gustavwrisberg/room-panel/hardware/kicad/production/bom.csv

Designator | Footprint | Quantity | Value | LCSC Part #
C10, C11, C12, C13, C14, C9 | 0402 | 6 | 100 nF | C1525
C15, C16 | 0402 | 2 | 10 nF | C15195
C7 | 0805 | 1 | 10 µF | C15850
J1 | C4002 | 1 | Conn_01x05
J2 | PinSocket_2x05_P2.54mm_Vertical | 1 | Conn_02x05_Odd_Even
J3 | JST_PH_B8B-PH-K_1x08_P2.00mm_Vertical | 1 | Conn_01x08
J4 | PinSocket_1x04_P2.54mm_Vertical | 1 | Conn_01x04
R10, R8, R9 | 0402 | 3 | 4k7 | C25900
R11, R12 | 0402 | 2 | 10k | C25744
SW1 | SW-SMD_BMQ22-N1A1-2012-A | 1 | BMQ22-N1A1-2012-A | C52740763
SW2, SW3, SW4, SW5 | SW-SMD_4P-L5.1-W5.1-P3.70-LS6.5-TL_H1.5 | 4 | TS-1187A-S16 | C318884
U1 | DFN-4_L1.5-W1.5-P0.80-TL-EP | 1 | SHT40-N-NF | C54946589
U2 | XIAO-ESP32-C6-SMD | 1 | XIAO-ESP32-C6-SMD | C27675191
U4 | WSOF-6_L2.6-W1.6-P0.50-TL-EP | 1 | BH1750FVI-TR | C78960
U5 | TSSOP-16_L5.0-W4.4-P0.65-LS6.4-BL | 1 | PCA9554PW,118 | C17230
