gustavwrisberg/room-panel/hardware/case/out/assembly.step

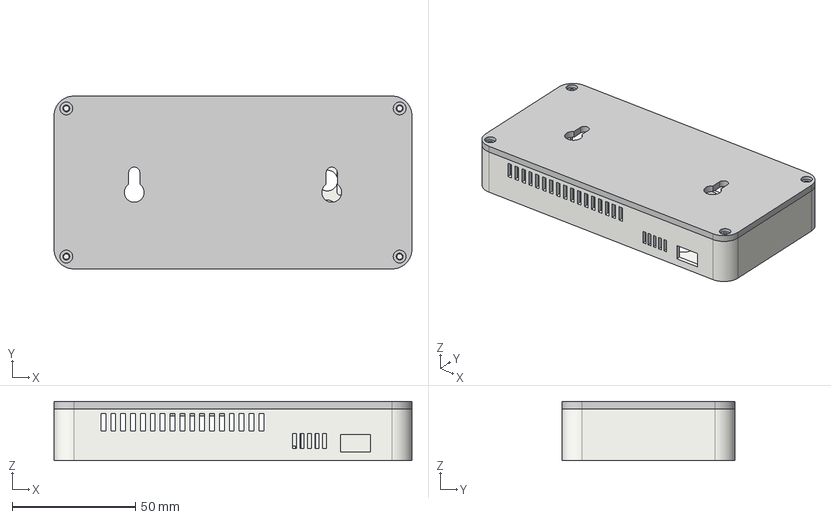
[picture p4: CAD file, 2026-11-03]
hardware/case/out/assembly.step
145.0 x 70.0 x 24.0 mm
front_shell
back_plate
