gustavwrisberg/room-panel/hardware/case/out/button_cap.step

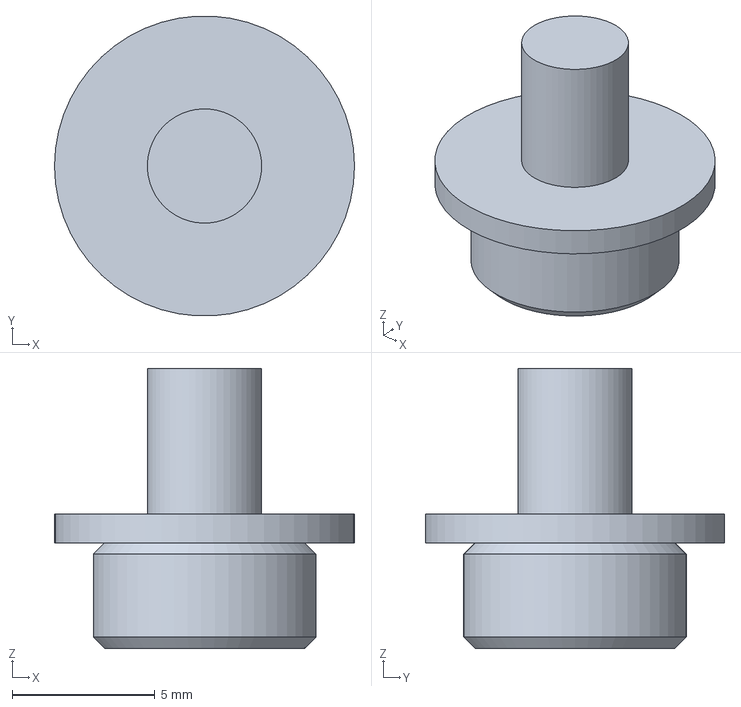
[picture p5: CAD file, 2026-11-03]
hardware/case/out/button_cap.step
10.5 x 10.5 x 9.80 mm
