gustavwrisberg/room-panel/hardware/case/out/back_plate.step

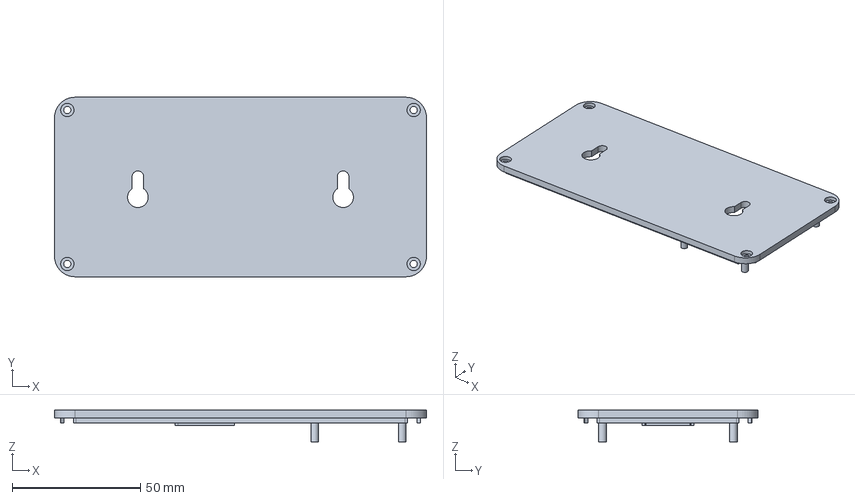
[picture p6: CAD file, 2026-11-03]
hardware/case/out/back_plate.step
145.0 x 70.0 x 12.4 mm
