gustavwrisberg/room-panel/hardware/case/out/knob.step

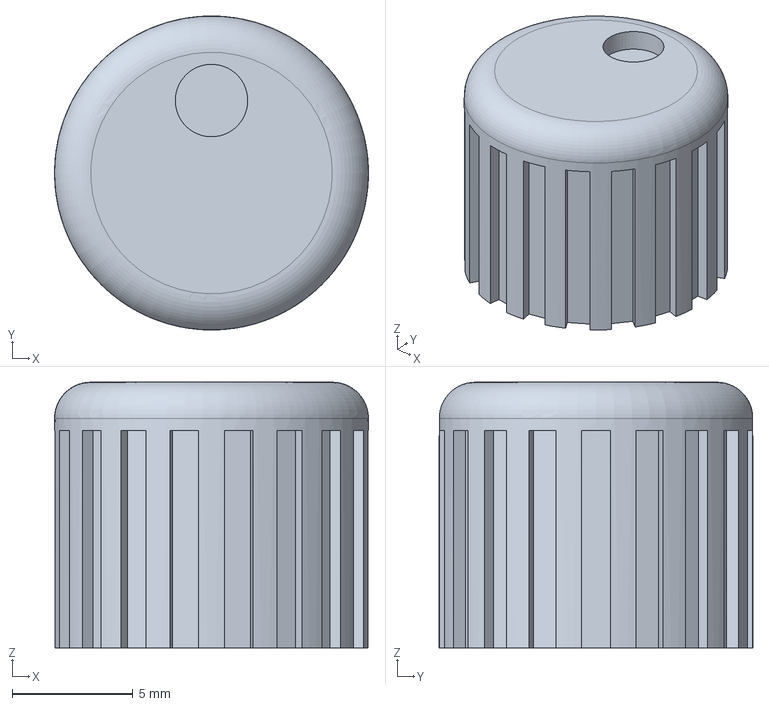
[picture p7: CAD file, 2026-11-03]
hardware/case/out/knob.step
13.0 x 13.0 x 11.0 mm
