gustavwrisberg/room-panel/hardware/case/out/front_shell.step

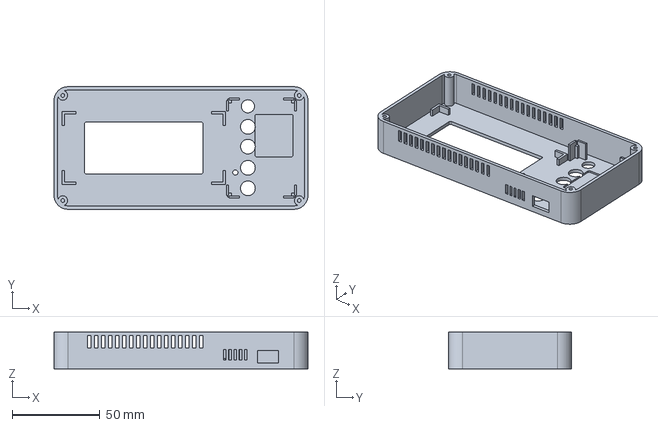
[picture p8: CAD file, 2026-11-03]
hardware/case/out/front_shell.step
145.0 x 70.0 x 21.0 mm
