gustavwrisberg/room-panel/(list of files, cad)

Other CAD files:
hardware/case/out/back_plate.stl
hardware/case/out/button_cap.stl
hardware/case/out/front_shell.stl
hardware/case/out/knob.stl
