gustavwrisberg/room-panel/hardware/kicad/Smart_home_universal_board.kicad_pcb

## KiCad design hardware/kicad/Smart_home_universal_board.kicad_pcb (2026-11-03)

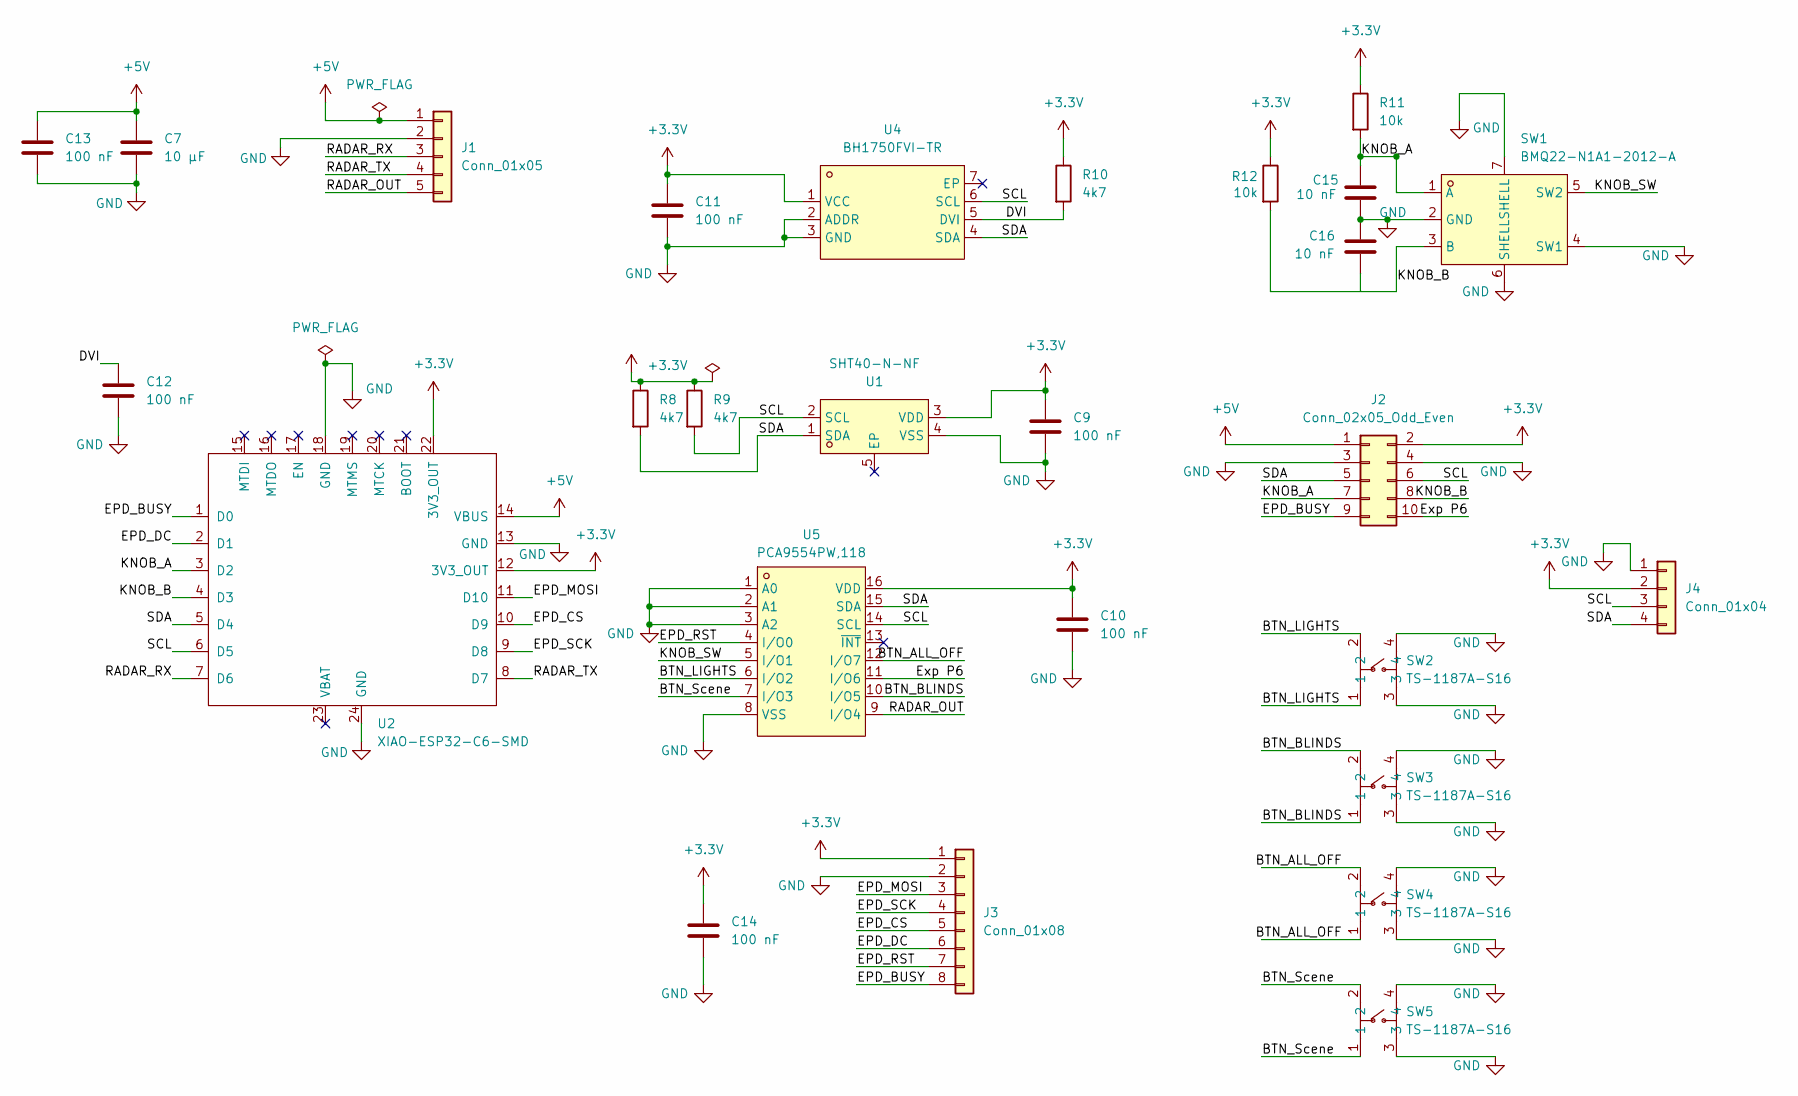
[picture p9: schematic Smart_home_universal_board.kicad_sch]

Parts:
C7: 10 µF; C_0805_2012Metric; LCSC Part C15850
C9, C10, C11, C12, C13, C14: 100 nF; C_0402_1005Metric; LCSC Part C1525
C15, C16: 10 nF; C_0402_1005Metric; LCSC Part C15195
J1: Conn_01x05; C4002
J2: Conn_02x05_Odd_Even; PinSocket_2x05_P2.54mm_Vertical
J3: Conn_01x08; JST_PH_B8B-PH-K_1x08_P2.00mm_Vertical
J4: Conn_01x04; PinSocket_1x04_P2.54mm_Vertical
R8, R9, R10: 4k7; R_0402_1005Metric; LCSC Part C25900
R11, R12: 10k; R_0402_1005Metric; LCSC Part C25744
SW1: BMQ22-N1A1-2012-A; SW-SMD_BMQ22-N1A1-2012-A; MPN BMQ22-N1A1-2012-A; LCSC Part C52740763
SW2, SW3, SW4, SW5: TS-1187A-S16; SW-SMD_4P-L5.1-W5.1-P3.70-LS6.5-TL_H1.5; MPN TS-1187A-S16; LCSC Part C318884
U1: SHT40-N-NF; DFN-4_L1.5-W1.5-P0.80-TL-EP; MPN SHT40-N-NF; LCSC Part C54946589
U2: XIAO-ESP32-C6-SMD; LCSC Part C27675191
U4: BH1750FVI-TR; WSOF-6_L2.6-W1.6-P0.50-TL-EP; MPN BH1750FVI-TR; LCSC Part C78960
U5: PCA9554PW,118; TSSOP-16_L5.0-W4.4-P0.65-LS6.4-BL; MPN PCA9554PW,118; LCSC Part C17230

Connections:
+3.3V: C9.1, C10.1, C11.1, C14.1, J2.2, J3.1, J4.2, R8.1, R9.1, R10.1, R11.1, R12.1, U1.3 (VDD), U2.12 (3V3_OUT), U2.22 (3V3_OUT), U4.1 (VCC), U5.16 (VDD)
+5V: C7.1, C13.1, J1.1, J2.1, U2.14 (VBUS)
/BTN_ALL_OFF: SW4.1, SW4.2, U5.12 (I/O7)
/BTN_BLINDS: SW3.1, SW3.2, U5.10 (I/O5)
/BTN_LIGHTS: SW2.1, SW2.2, U5.6 (I/O2)
/BTN_Scene: SW5.1, SW5.2, U5.7 (I/O3)
/DVI: C12.1, R10.2, U4.5 (DVI)
/EPD_BUSY: J2.9, J3.8, U2.1 (D0)
/EPD_CS: J3.5, U2.10 (D9)
/EPD_DC: J3.6, U2.2 (D1)
/EPD_MOSI: J3.3, U2.11 (D10)
/EPD_RST: J3.7, U5.4 (I/O0)
/EPD_SCK: J3.4, U2.9 (D8)
/Exp P6: J2.10, U5.11 (I/O6)
/KNOB_A: C15.1, J2.7, R11.2, SW1.1 (A), U2.3 (D2)
/KNOB_B: J2.8, R12.2, SW1.3 (B), U2.4 (D3)
/KNOB_SW: SW1.5 (SW2), U5.5 (I/O1)
/RADAR_OUT: J1.5, U5.9 (I/O4)
/RADAR_RX: J1.3, U2.7 (D6)
/RADAR_TX: J1.4, U2.8 (D7)
/SCL: J2.6, J4.3, R9.2, U1.2 (SCL), U2.6 (D5), U4.6 (SCL), U5.14 (SCL)
/SDA: J2.5, J4.4, R8.2, U1.1 (SDA), U2.5 (D4), U4.4 (SDA), U5.15 (SDA)
GND: C7.2, C9.2, C10.2, C11.2, C12.2, C13.2, C14.2, C15.2, C16.1, J1.2, J2.3, J2.4, J3.2, J4.1, SW1.2 (GND), SW1.4 (SW1), SW1.6 (SHELL), SW1.7 (SHELL), SW2.3, SW2.4, SW3.3, SW3.4, SW4.3, SW4.4, SW5.3, SW5.4, U1.4 (VSS), U2.13 (GND), U2.18 (GND), U2.24 (GND), U4.2 (ADDR), U4.3 (GND), U5.1 (A0), U5.2 (A1), U5.3 (A2), U5.8 (VSS)

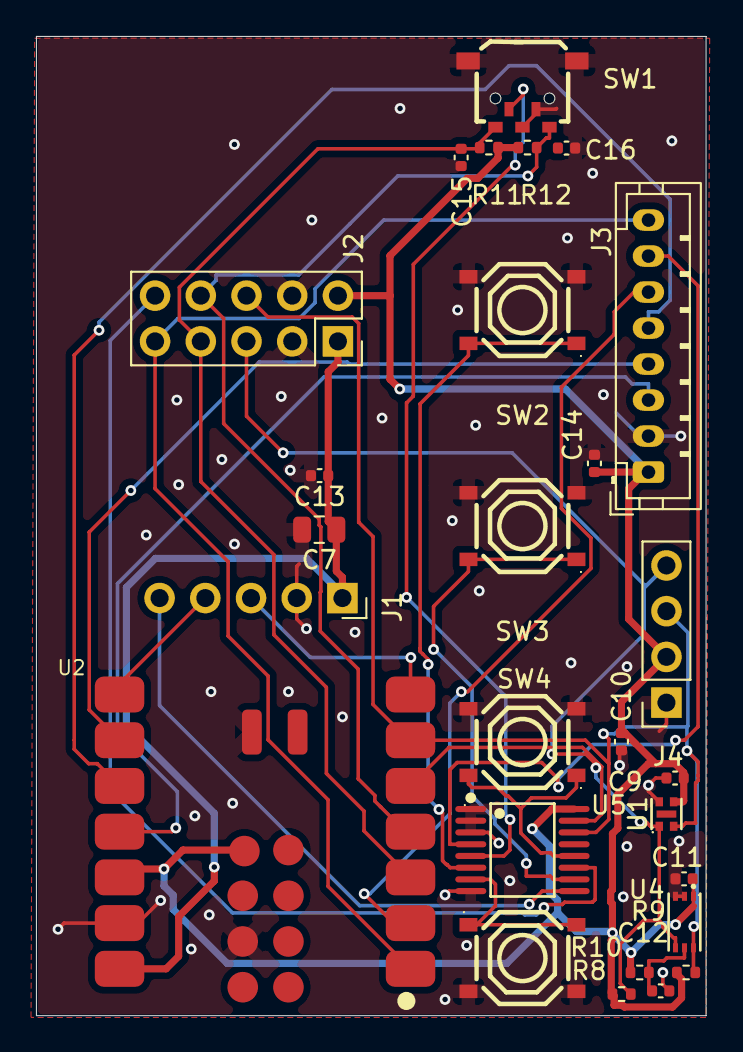
[picture p10: board Smart_home_universal_board.kicad_pcb from above]

Board: 2 copper layers, 37.2 x 54.4 mm, 27 parts (0 on the bottom side), 23 nets.
