gustavwrisberg/room-panel/(commit log)

2026-11-03 Room panel: BOM, case, ESPHome config and docs
    Claude-Session: https://claude.ai/code/session_015yZaeHK9gXCjaV8nt7jpa4
    [BOM.csv, assembly.step, back_plate.step, back_plate.stl, button_cap.step, button_cap.stl, front_shell.step, front_shell.stl]
2026-11-03 Add KiCad project and JLCPCB production files; confirm expander button pins
    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
    [Smart_home_universal_board.kicad_pcb, Smart_home_universal_board.kicad_sch, bom.csv, designators.csv, positions.csv]
2026-11-03 README: KiCad folder description
    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
2026-11-03 KiCad: add project libraries, fix LCSC numbers for C15/C16 and R11/R12
    Symbols and footprints extracted from the embedded copies in the schematic and
    PCB, with project-relative sym/fp lib tables.
    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
    [Smart_home_universal_board.kicad_pcb, Smart_home_universal_board.kicad_sch, bom.csv]
2026-11-03 KiCad: restore CRLF line endings in schematic and PCB
    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
    [Smart_home_universal_board.kicad_pcb, Smart_home_universal_board.kicad_sch]
2026-11-03 KiCad: use the original EasyEDA library with 3D models
    Replaces the footprints and symbols rebuilt from the board with the originals
    from the impartGUI library, trimmed to the parts used on this board.
    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
2026-11-03 Add 3D render of the PCB with C4002 radar and e-paper display
    Rendered from the KiCad board file with the EasyEDA/KiCad STEP models.
    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
2026-11-03 Render the panel in its case, add SCD41 breakout; fix connector and knob fit
    - Closed and exploded case renders, SCD41 breakout in the CO2 cradle
    - J3 goes on the back of the PCB and the SCD41 wires are soldered into J4
    from the back: there is only 8 mm under the front panel
    - Knob reduced to 13 mm so it no longer covers button 1; indicator dot moved
    off the fillet so the STL is watertight
    - BOM updated (no J4 socket, silicone wire instead of Dupont cable)
    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
    [BOM.csv, assembly.step, back_plate.step, button_cap.step, front_shell.step, knob.step, knob.stl]
